MD-AYAAN/automotive-bms-edge-ai/esp32_intelligence_layer/bms_cnn_model.h

/*
 * BMS 1D CNN Thermal Runaway Prediction Model
 * Trained on 10,000 calibrated synthetic sequences
 * 
 * Architecture: Conv1D(32) -> Conv1D(64) -> Conv1D(32) -> GAP -> Dense(32) -> Dense(4)
 * Input: 30 timesteps x 14 features (float32)
 * Output: 4 classes [NORMAL, WARNING, HIGH, DANGER]
 * Size: 29616 bytes (28.9 KB)
 * Test Accuracy: 98.3%
 * TFLite Accuracy: 98.5%
 * Training Data: 10,000 sequences (16 scenarios)
 * 
 * PREDICTION MEANING:
 *   NORMAL  -> Battery is safe, no action needed
 *   WARNING -> Early signs detected, 15-20 min before critical
 *   HIGH    -> Fault developing, take action within 10-15 min
 *   DANGER  -> Thermal runaway imminent, EVACUATE
 */
 
#ifndef BMS_CNN_MODEL_H
#define BMS_CNN_MODEL_H
 
const unsigned char bms_cnn_model[] = {
  0x1c, 0x00, 0x00, 0x00, 0x54, 0x46, 0x4c, 0x33, 0x14, 0x00, 0x20, 0x00, 
  0x1c, 0x00, 0x18, 0x00, 0x14, 0x00, 0x10, 0x00, 0x0c, 0x00, 0x00, 0x00, 
  0x08, 0x00, 0x04, 0x00, 0x14, 0x00, 0x00, 0x00, 0x1c, 0x00, 0x00, 0x00, 
  0x8c, 0x00, 0x00, 0x00, 0xe4, 0x00, 0x00, 0x00, 0x6c, 0x40, 0x00, 0x00, 
  0x7c, 0x40, 0x00, 0x00, 0x98, 0x72, 0x00, 0x00, 0x03, 0x00, 0x00, 0x00, 
  0x01, 0x00, 0x00, 0x00, 0x04, 0x00, 0x00, 0x00, 0x76, 0xbc, 0xff, 0xff, 
  0x0c, 0x00, 0x00, 0x00, 0x1c, 0x00, 0x00, 0x00, 0x3c, 0x00, 0x00, 0x00, 
  0x0f, 0x00, 0x00, 0x00, 0x73, 0x65, 0x72, 0x76, 0x69, 0x6e, 0x67, 0x5f, 
  0x64, 0x65, 0x66, 0x61, 0x75, 0x6c, 0x74, 0x00, 0x01, 0x00, 0x00, 0x00, 
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
};

#define MODEL_SEQ_LENGTH 30
#define MODEL_NUM_FEATURES 14
#define MODEL_NUM_CLASSES 4
// 0=NORMAL, 1=WARNING, 2=HIGH, 3=DANGER

#endif // BMS_CNN_MODEL_H
